LesKaribous/Karibous-2024-PAMI/ECAD/Librairies/ff5a3e2b9e6f647bb54e8a6d02c0a6f1.jpg

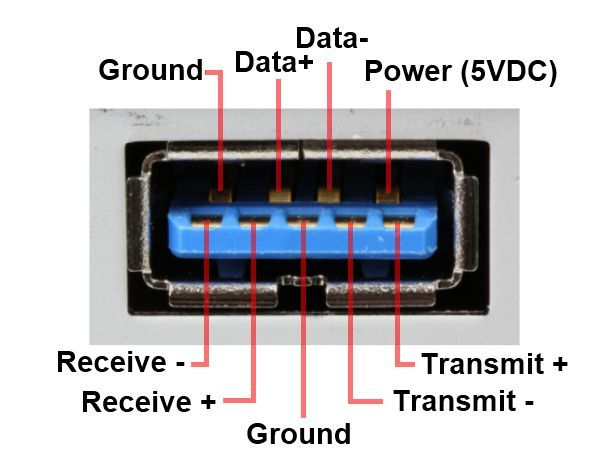
ECAD/Librairies/ff5a3e2b9e6f647bb54e8a6d02c0a6f1.jpg
