LesKaribous/Karibous-2024-PAMI/ECAD/Librairies/ConnectorUSB3.jpg

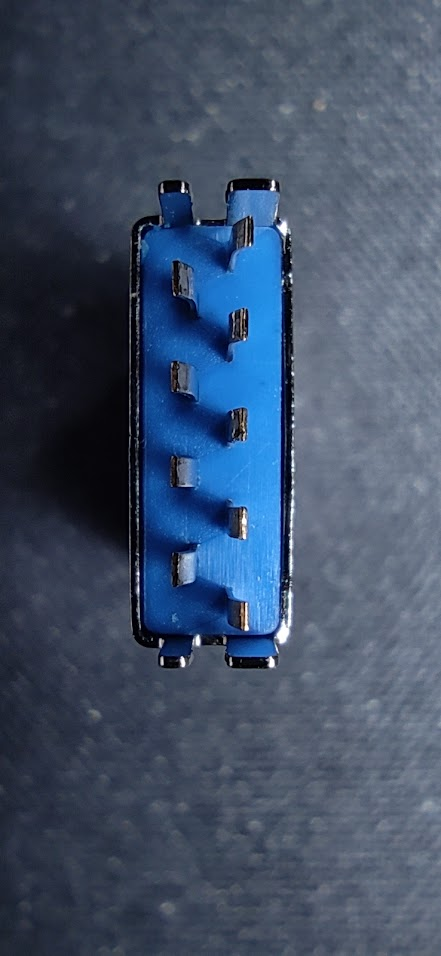
ECAD/Librairies/ConnectorUSB3.jpg
