LesKaribous/Karibous-2024-PAMI/README.md

# Karibous-2024-PAMI
Hardware pour les Petits Automates Mobiles Indépendants de la Coupe de France de Robotique 2024
