LesKaribous/Karibous-2024-PAMI/ECAD/Librairies/H6ca099008dd04cd7b9c7c0162c8ac43c6.png

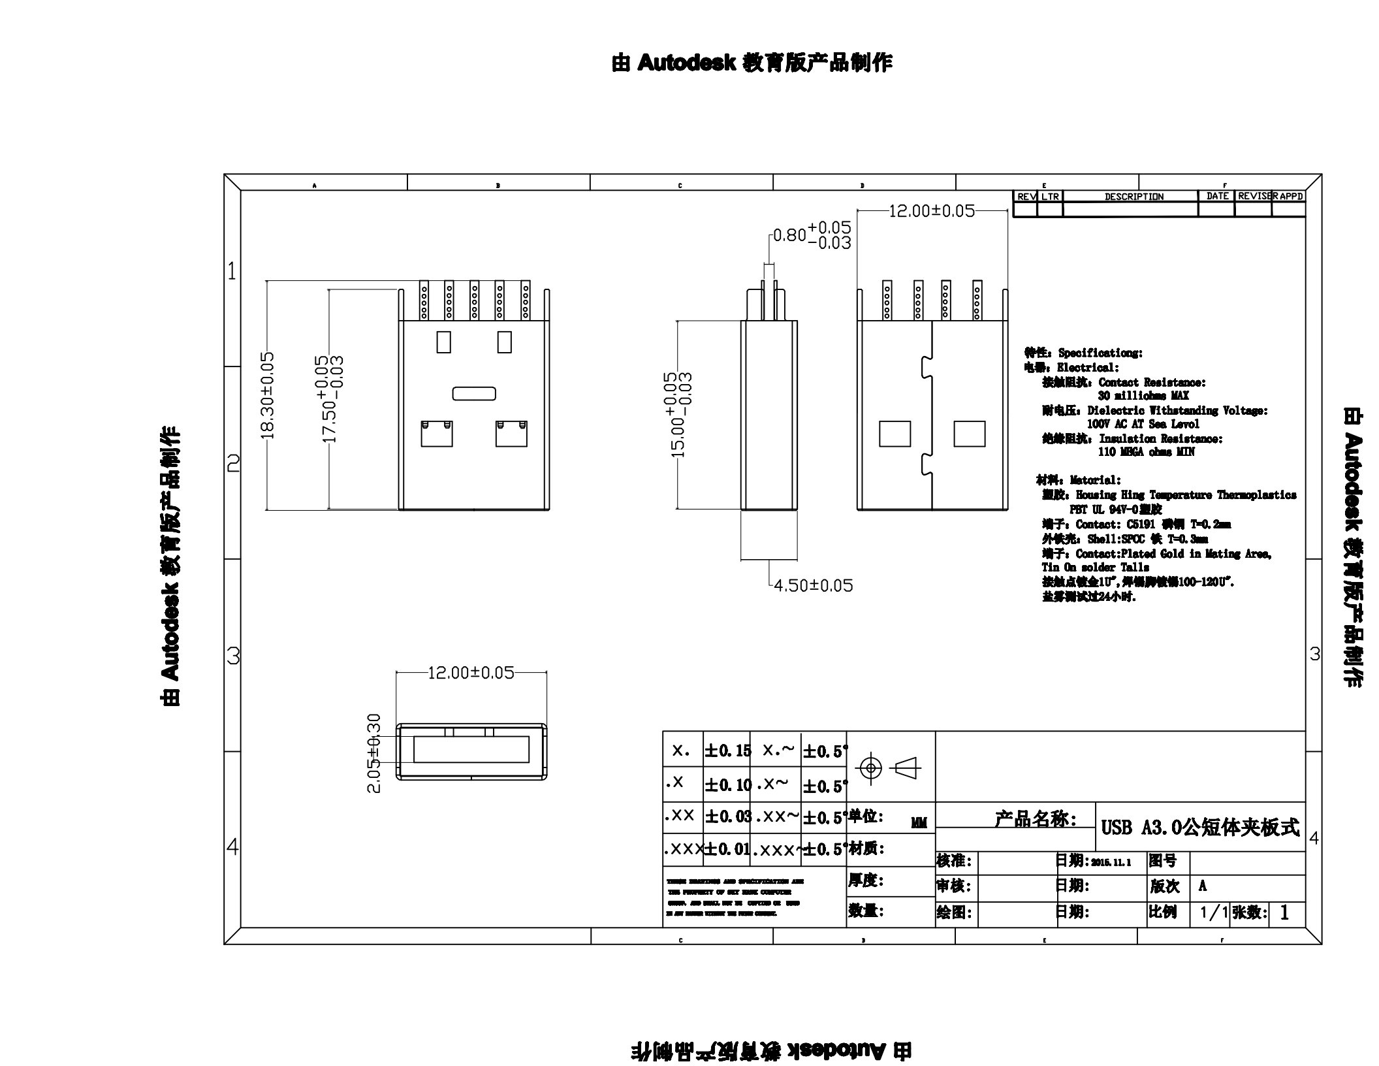
ECAD/Librairies/H6ca099008dd04cd7b9c7c0162c8ac43c6.png
