LesKaribous/Karibous-2024-PAMI/ECAD/Librairies/H062c9b681e61475f8c1c907234bb61a5Y.png_960x960.webp

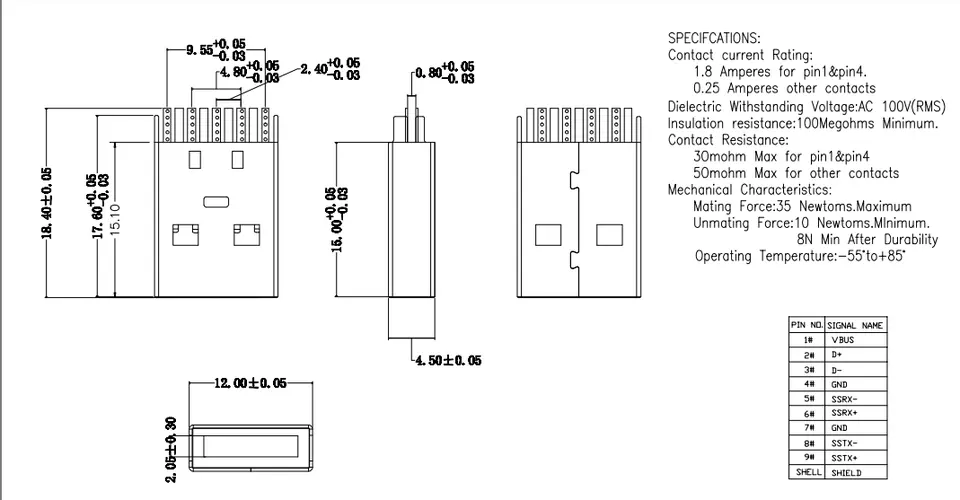
ECAD/Librairies/H062c9b681e61475f8c1c907234bb61a5Y.png_960x960.webp
