LesKaribous/Karibous-2024-PAMI/ECAD/MainBoard-PAMI-2024/Ladybug.png

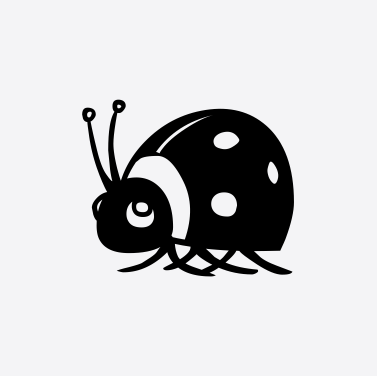
ECAD/MainBoard-PAMI-2024/Ladybug.png
