LesKaribous/Karibous-2024-PAMI/ECAD/MainBoard-PAMI-2024/Pencil.png

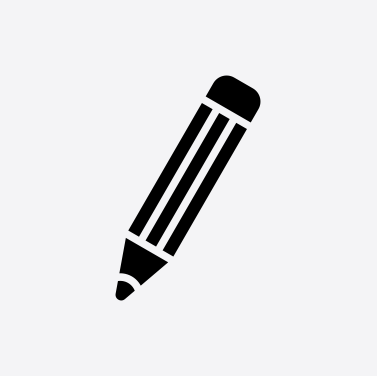
ECAD/MainBoard-PAMI-2024/Pencil.png
