LesKaribous/Karibous-2024-PAMI/ECAD/BatteryAdaptator-2024/BatteryAdaptator-2024.step

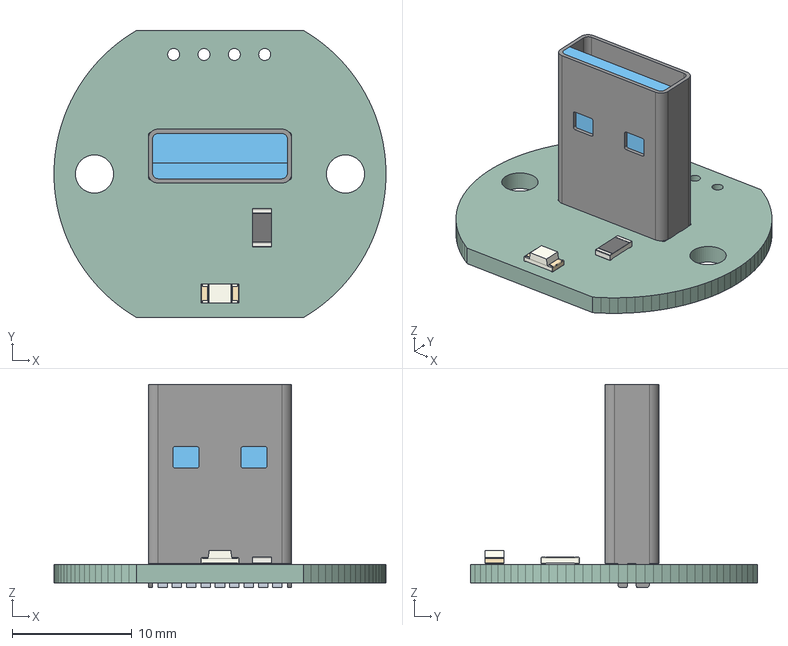
[picture p7: CAD file, 2023-10-08]
ECAD/BatteryAdaptator-2024/BatteryAdaptator-2024.step
27.8 x 24.0 x 17.0 mm
BatteryAdaptator-2024 PCB
