LesKaribous/Karibous-2024-PAMI/ECAD/Librairies/Dissipateur.FCStd

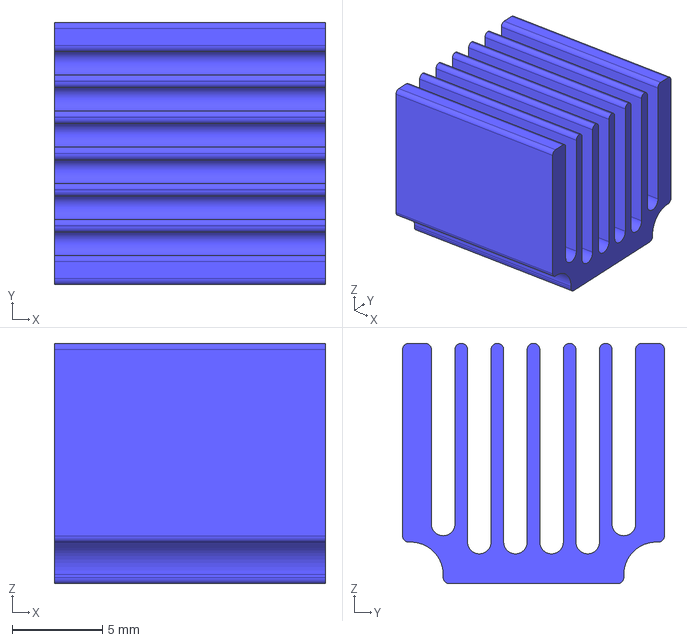
[picture p8: CAD file, 2023-10-30]
ECAD/Librairies/Dissipateur.FCStd
15.0 x 14.5 x 13.3 mm
