LesKaribous/Karibous-2024-PAMI/ECAD/Librairies/TMC2208_SILENTSTEPSTICK/TMC2208_SILENTSTEPSTICK.step

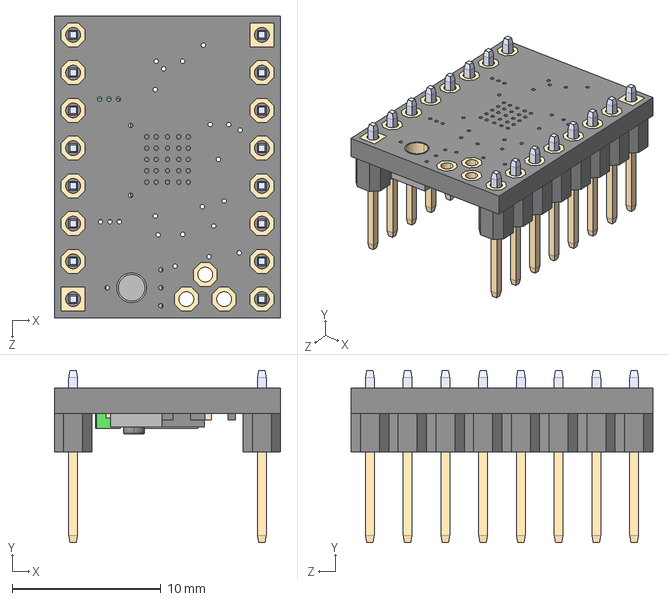
[picture p9: CAD file, 2023-10-21]
ECAD/Librairies/TMC2208_SILENTSTEPSTICK/TMC2208_SILENTSTEPSTICK.step
15.2 x 11.6 x 20.3 mm
