LesKaribous/Karibous-2024-PAMI/MCAD/pami-parts/servo-horn.FCStd

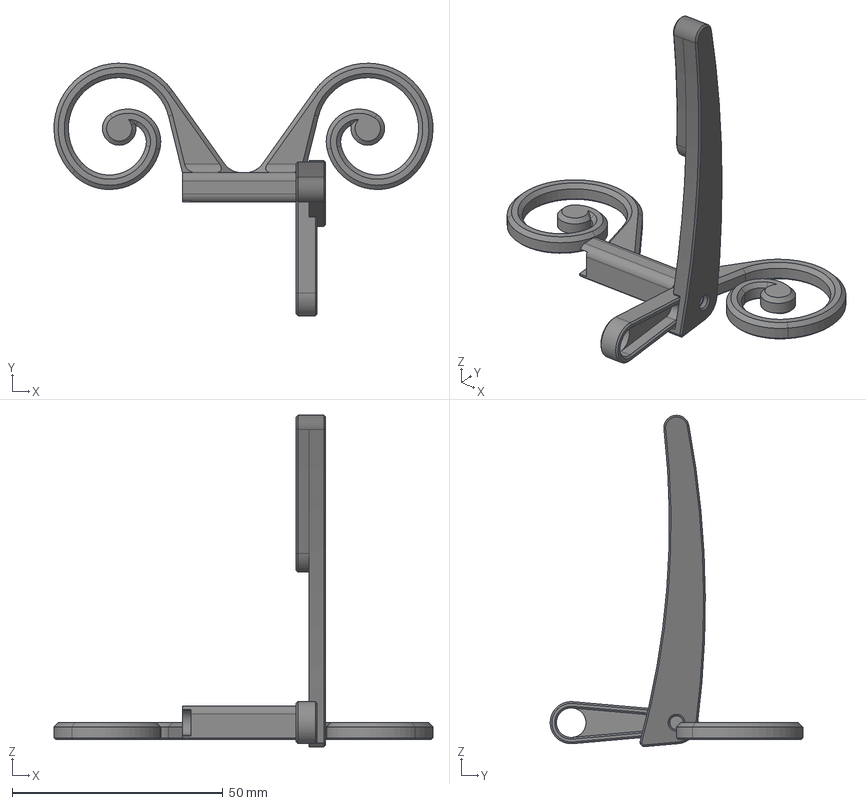
[picture p10: CAD file, 2025-05-25]
MCAD/pami-parts/servo-horn.FCStd
90.0 x 60.0 x 78.7 mm
Horn
Antennas
BrasCrayon
