LesKaribous/Karibous-2024-PAMI/ECAD/Librairies/PinSocket_1x08_P2.54mm_Vertical.step

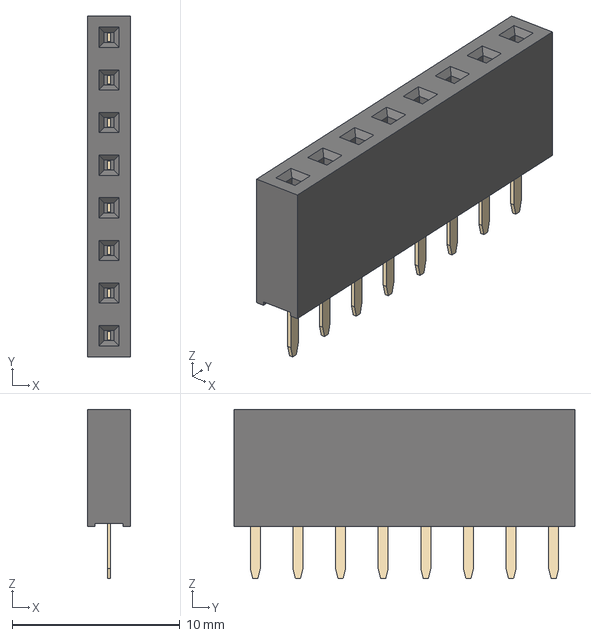
[picture p11: CAD file, 2023-10-30]
ECAD/Librairies/PinSocket_1x08_P2.54mm_Vertical.step
2.54 x 20.3 x 10.1 mm
