LesKaribous/Karibous-2024-PAMI/MCAD/CaleBordure.FCStd

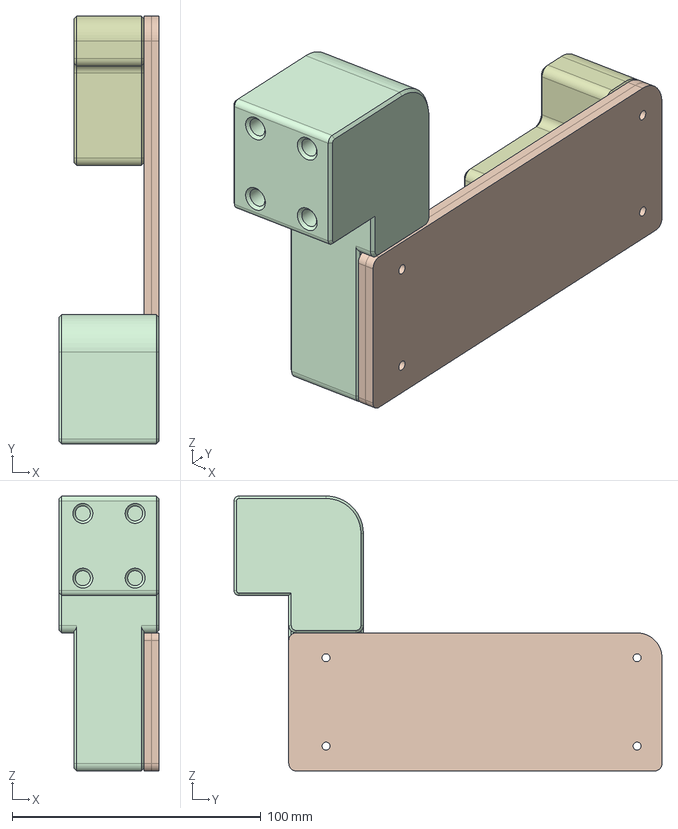
[picture p12: CAD file, 2024-04-07]
MCAD/CaleBordure.FCStd
40.0 x 172.0 x 110.5 mm
V2-BaseClamp
PlateDatum x 2
TIPDatumTool
