LesKaribous/Karibous-2024-PAMI/MCAD/pami-parts/tirette-pami-magnet.FCStd

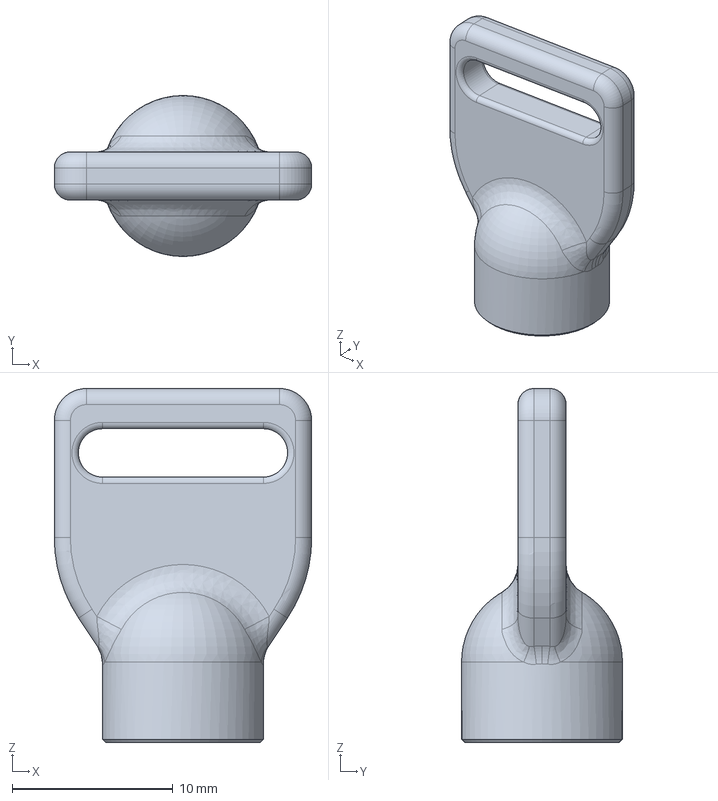
[picture p13: CAD file, 2024-05-01]
MCAD/pami-parts/tirette-pami-magnet.FCStd
16.0 x 10.00 x 22.0 mm
