LesKaribous/Karibous-2024-PAMI/ECAD/Librairies/USB_A_3_Vertical.FCStd

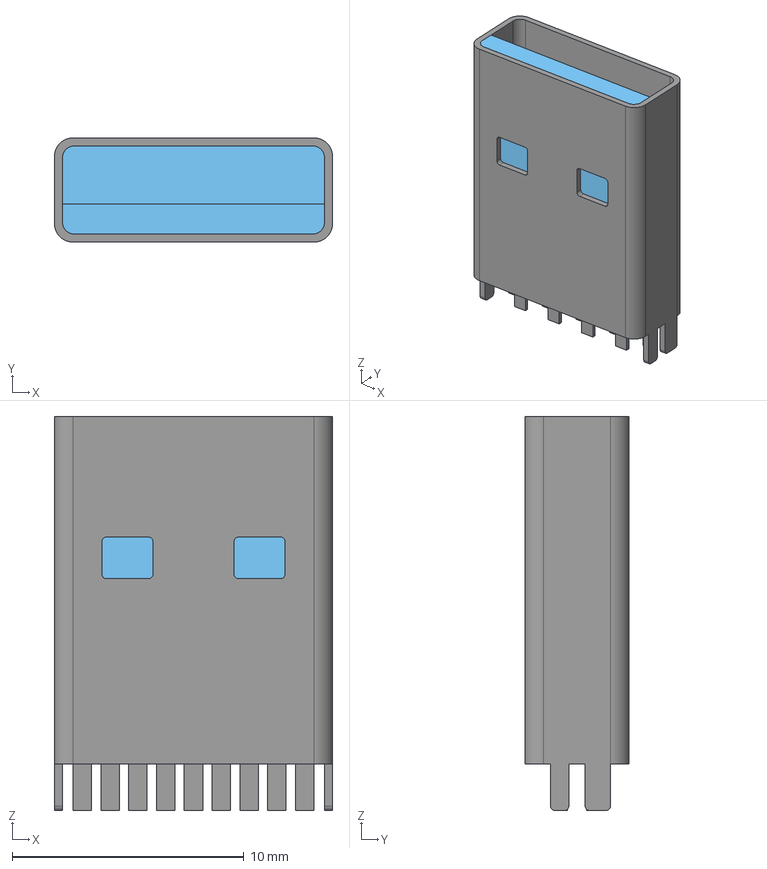
[picture p14: CAD file, 2023-10-08]
ECAD/Librairies/USB_A_3_Vertical.FCStd
12.0 x 4.50 x 17.0 mm
Shield
BlueSupport
Pins
