LesKaribous/Karibous-2024-PAMI/MCAD/DummyPAMI.FCStd

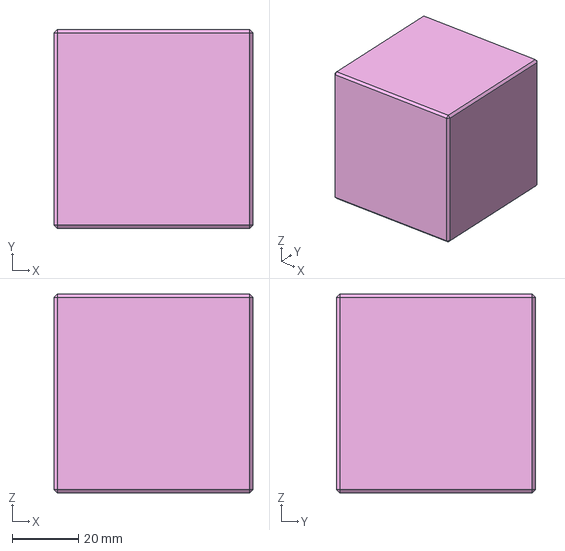
[picture p15: CAD file, 2023-12-13]
MCAD/DummyPAMI.FCStd
60.0 x 60.0 x 60.0 mm
