LesKaribous/Karibous-2024-PAMI/MCAD/pami-parts/motorisation-pami.FCStd

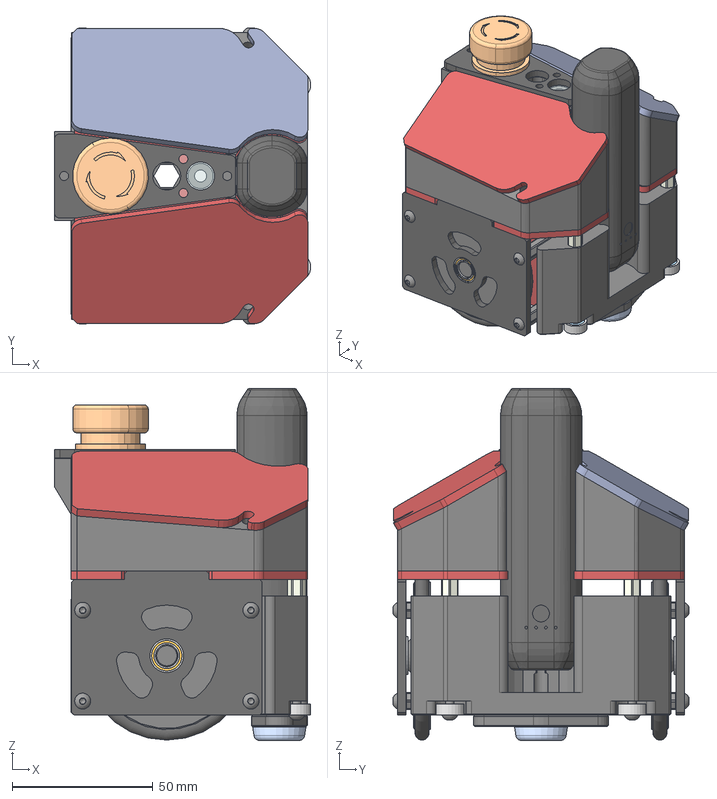
[picture p16: CAD file, 2023-09-24]
MCAD/pami-parts/motorisation-pami.FCStd
91.2 x 105.3 x 125.2 mm
ReedSensorShort
17HS08-1004S x 2
Roue60mm x 2
JointTorique x 2
M3-Insert004 x 4
M3-Insert005 x 4
M3x3-Screw x 4
M3x3-Screw001 x 4
CoreMF128 x 2
SleeveMF128 x 2
MotorPlate x 2
M3x20xx6-Standoff x 4
M3x20xx6-Standoff001 x 4
M3x20xx6-Standoff002 x 4
M3x20xx6-Standoff003 x 4
M3-Insert x 4
M3-Insert001 x 4
M3-Insert002 x 4
M3-Insert003 x 4
M3x6-Screw x 4
M3x6-Screw032 x 4
M3x6-Screw033 x 4
M3x6-Screw034 x 4
M3x6-Screw007 x 4
M3x6-Screw008 x 4
M3x6-Screw009 x 4
M3x6-Screw010 x 4
WheelPlate x 2
MainBody
M3-Insert401 x 2
M3-Insert402 x 2
M3x12-Screw x 2
M3x12-Screw001 x 2
SupportPatin
Patin
M3x8-Screw
M3x8-Screw001
M3-Insert046
M3-Insert047
M3-Insert403 x 2
M3-Insert404 x 2
M3-Insert405 x 2
M3-Insert406 x 2
M3-Insert407 x 2
M3x6xx6-Standoff x 2
M3x6xx6-Standoff071 x 2
M3x6xx6-Standoff072 x 2
TopPlate
PowerBank-B0BHZ6RY6C
BAU
CarterSuperieur
AileGauche
AileDroite
TopCarter
BrideReed
TransferCarter
M4-Washer
