LesKaribous/Karibous-2024-PAMI/MCAD/pami-parts/Roulements623ZZ.step

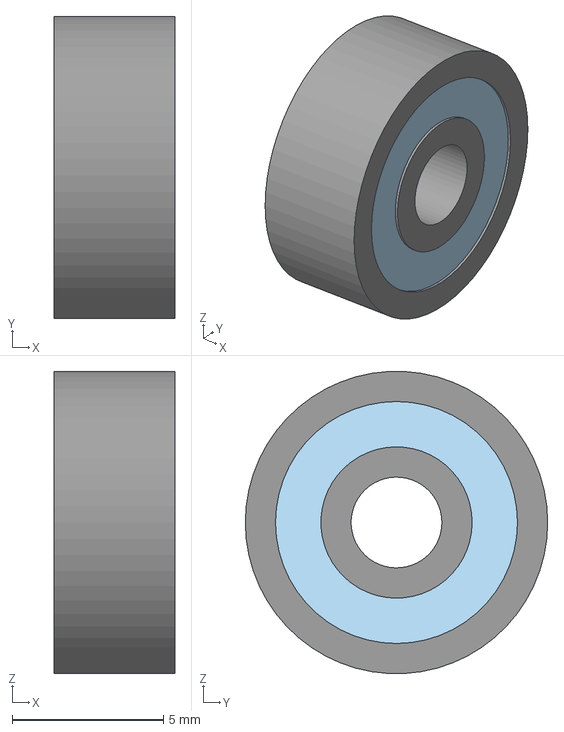
[picture p17: CAD file, 2023-09-23]
MCAD/pami-parts/Roulements623ZZ.step
4.00 x 10.0 x 9.99 mm
