LesKaribous/Karibous-2024-PAMI/MCAD/pami-parts/RoulementsMF128.step

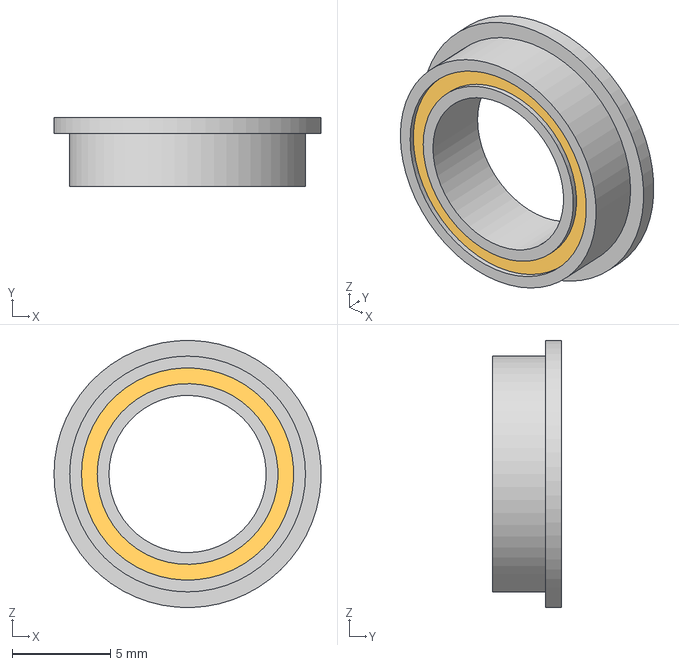
[picture p18: CAD file, 2023-09-23]
MCAD/pami-parts/RoulementsMF128.step
13.6 x 3.50 x 13.6 mm
CoreMF128
SleeveMF128
