LesKaribous/Karibous-2024-PAMI/MCAD/pami-parts/RCWL-1601.step

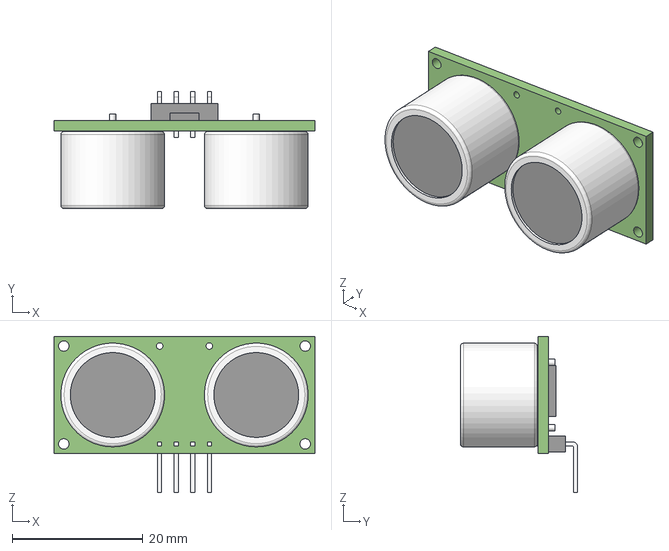
[picture p19: CAD file, 2023-09-23]
MCAD/pami-parts/RCWL-1601.step
40.0 x 18.0 x 24.0 mm
