LesKaribous/Karibous-2024-PAMI/(list of files, cad)

Other CAD files:
MCAD/pami_2024.FCStd
MCAD/pami-parts/tirette-pami.FCStd
