LesKaribous/Karibous-2024-PAMI/ECAD/MainBoard-PAMI-2024/MainBoard-PAMI-2024.kicad_pcb

## KiCad design ECAD/MainBoard-PAMI-2024/MainBoard-PAMI-2024.kicad_pcb (2023-11-02)

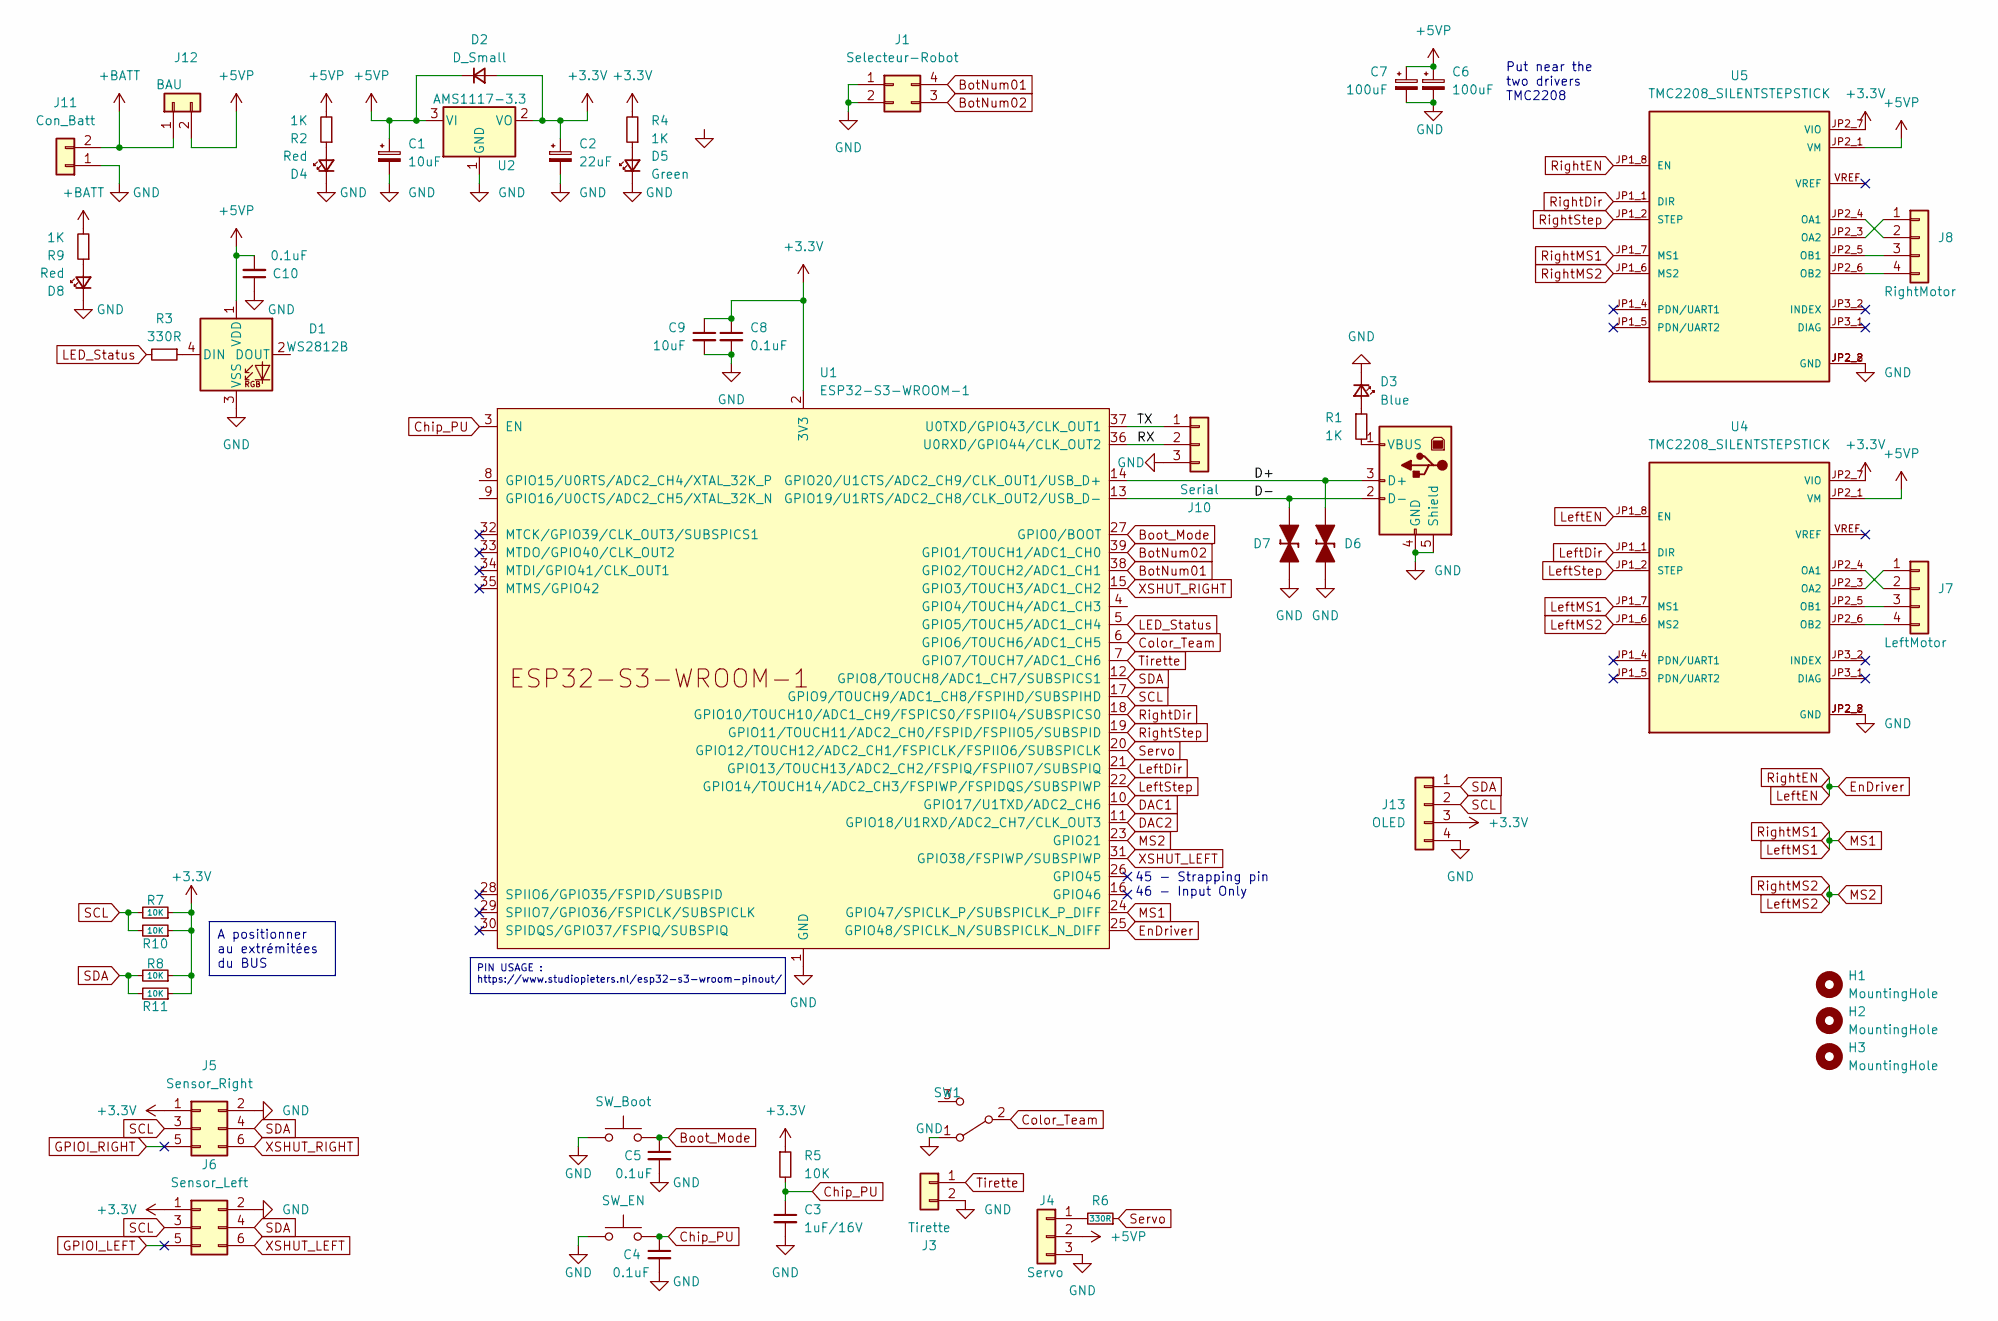
[picture p20: schematic MainBoard-PAMI-2024.kicad_sch]

Parts:
C1: 10uF; CP_Elec_5x5.4
C2: 22uF; CP_EIA-3528-12_Kemet-T_Pad1.50x2.35mm_HandSolder
C3: 1uF/16V; C_1206_3216Metric
C4, C5, C10: 0.1uF; C_1206_3216Metric
C6, C7: 100uF; CP_Radial_D8.0mm_P3.80mm
C8: 0.1uF; C_1206_3216Metric_Pad1.33x1.80mm_HandSolder
C9: 10uF; C_1206_3216Metric_Pad1.33x1.80mm_HandSolder
D1: WS2812B; LED_WS2812B_PLCC4_5.0x5.0mm_P3.2mm
D2: D_Small; D_SMA_Handsoldering
D3: Blue; LED_1206_3216Metric
D4, D8: Red; LED_1206_3216Metric
D5: Green; LED_1206_3216Metric
D6, D7: D_TVS_Bidirectional_Generic; D_SOD-523
H1, H2, H3: MountingHole; MountingHole_3.2mm_M3
J1: Selecteur-Robot; PinHeader_2x02_P2.54mm_Vertical
J2: USB_B; USB_B_Lumberg_2411_02_Horizontal
J3: Tirette; Molex_KK-254_AE-6410-02A_1x02_P2.54mm_Vertical
J4: Servo; PinHeader_1x03_P2.54mm_Vertical
J5: Sensor_Right; IDC-Header_2x03_P2.54mm_Vertical
J6: Sensor_Left; IDC-Header_2x03_P2.54mm_Vertical
J7: LeftMotor; PinHeader_1x04_P2.54mm_Vertical
J8: RightMotor; PinHeader_1x04_P2.54mm_Vertical
J10: Serial; PinHeader_1x03_P2.54mm_Vertical
J11: Con_Batt; AMASS_XT30U-F_1x02_P5.0mm_Vertical
J12: BAU; Molex_KK-396_A-41791-0002_1x02_P3.96mm_Vertical
J13: OLED; Molex_KK-254_AE-6410-04A_1x04_P2.54mm_Vertical
R1, R2, R4, R9: 1K; R_1206_3216Metric_Pad1.30x1.75mm_HandSolder
R3, R6: 330R; R_1206_3216Metric_Pad1.30x1.75mm_HandSolder
R5, R7, R8, R10, R11: 10K; R_1206_3216Metric_Pad1.30x1.75mm_HandSolder
SW1: SW_SPDT; SK-12D10 1P2T
SWBoot1: SW_Boot; SW_SPST_CK_RS282G05A3
SWEn1: SW_EN; SW_SPST_CK_RS282G05A3
U1: ESP32-S3-WROOM-1
U2: AMS1117-3.3; SOT-223-3_TabPin2
U4, U5: TMC2208_SILENTSTEPSTICK; MODULE_TMC2208_SILENTSTEPSTICK

Connections:
+3.3V: C2.1, C8.1, C9.1, D2.2 (A), J5.1, J6.1, J13.3, R4.2, R5.1, R7.1, R8.1, R10.1, R11.1, U1.2 (3V3), U2.2 (VO), U4.JP2_7 (VIO), U5.JP2_7 (VIO)
+5VP: C1.1, C6.1, C7.1, C10.2, D1.1 (VDD), D2.1 (K), J4.2, J12.2, R2.2, U2.3 (VI), U4.JP2_1 (VM), U5.JP2_1 (VM)
+BATT: J11.2, J12.1, R9.2
/D+: D6.2 (A), J2.3 (D+), U1.14 (GPIO20/U1CTS/ADC2_CH9/CLK_OUT1/USB_D+)
/D-: D7.2 (A), J2.2 (D-), U1.13 (GPIO19/U1RTS/ADC2_CH8/CLK_OUT2/USB_D-)
/RX: J10.2, U1.36 (U0RXD/GPIO44/CLK_OUT2)
/TX: J10.1, U1.37 (U0TXD/GPIO43/CLK_OUT1)
Boot_Mode: C5.1, SWBoot1.2, U1.27 (GPIO0/BOOT)
BotNum01: J1.4, U1.38 (GPIO2/TOUCH2/ADC1_CH1)
BotNum02: J1.3, U1.39 (GPIO1/TOUCH1/ADC1_CH0)
Chip_PU: C3.1, C4.1, R5.2, SWEn1.2, U1.3 (EN)
Color_Team: SW1.2 (B), U1.6 (GPIO6/TOUCH6/ADC1_CH5)
DAC1: U1.10 (GPIO17/U1TXD/ADC2_CH6)
DAC2: U1.11 (GPIO18/U1RXD/ADC2_CH7/CLK_OUT3)
EnDriver: U1.25 (GPIO48/SPICLK_N/SUBSPICLK_N_DIFF), U4.JP1_8 (EN), U5.JP1_8 (EN)
GND: C1.2, C2.2, C3.2, C4.2, C5.2, C6.2, C7.2, C8.2, C9.2, C10.1, D1.3 (VSS), D3.1 (K), D4.1 (K), D5.1 (K), D6.1 (K), D7.1 (K), D8.1 (K), J1.1, J1.2, J2.4 (GND), J2.5 (Shield), J3.2, J4.3, J5.2, J6.2, J10.3, J11.1, J13.4, SW1.1 (A), SWBoot1.1, SWEn1.1, U1.1 (GND), U1.40 (GND), U1.41 (GND), U2.1 (GND), U4.JP2_2 (GND), U4.JP2_8 (GND), U5.JP2_2 (GND), U5.JP2_8 (GND)
GPIOI_LEFT: J6.5
GPIOI_RIGHT: J5.5
LED_Status: R3.2, U1.5 (GPIO5/TOUCH5/ADC1_CH4)
LeftDir: U1.21 (GPIO13/TOUCH13/ADC2_CH2/FSPIQ/FSPIIO7/S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), U4.JP1_1 (DIR)
LeftMS1: U1.24 (GPIO47/SPICLK_P/SUBSPICLK_P_DIFF), U4.JP1_7 (MS1), U5.JP1_7 (MS1)
LeftMS2: U1.23 (GPIO21), U4.JP1_6 (MS2), U5.JP1_6 (MS2)
LeftStep: U1.22 (GPIO14/TOUCH14/ADC2_CH3/FSPIWP/FSPIDQS/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), U4.JP1_2 (STEP)
unnamed: D1.4 (DIN), R3.1
unnamed: D3.2 (A), R1.1
unnamed: D4.2 (A), R2.1
unnamed: D5.2 (A), R4.1
unnamed: D8.2 (A), R9.1
unnamed: J2.1 (VBUS), R1.2
unnamed: J4.1, R6.2
unnamed: J7.1, U4.JP2_3 (OA2)
unnamed: J7.2, U4.JP2_4 (OA1)
unnamed: J7.3, U4.JP2_5 (OB1)
unnamed: J7.4, U4.JP2_6 (OB2)
unnamed: J8.1, U5.JP2_3 (OA2)
unnamed: J8.2, U5.JP2_4 (OA1)
unnamed: J8.3, U5.JP2_5 (OB1)
unnamed: J8.4, U5.JP2_6 (OB2)
RightDir: U1.18 (GPIO10/TOUCH10/ADC1_CH9/FSPICS0/FSPIIO4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), U5.JP1_1 (DIR)
RightStep: U1.19 (GPIO11/TOUCH11/ADC2_CH0/FSPID/FSPIIO5/S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), U5.JP1_2 (STEP)
SCL: J5.3, J6.3, J13.2, R7.2, R10.2, U1.17 (GPIO9/TOUCH9/ADC1_CH8/FSPIHD/SUBSPIHD)
SDA: J5.4, J6.4, J13.1, R8.2, R11.2, U1.12 (GPIO8/TOUCH8/ADC1_CH7/SUBSPICS1)
Servo: R6.1, U1.20 (GPIO12/TOUCH12/ADC2_CH1/FSPICLK/FSPIIO6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)
Tirette: J3.1, U1.7 (GPIO7/TOUCH7/ADC1_CH6)
XSHUT_LEFT: J6.6, U1.31 (GPIO38/FSPIWP/SUBSPIWP)
XSHUT_RIGHT: J5.6, U1.15 (GPIO3/TOUCH3/ADC1_CH2)

Notes on the sheet:
PIN USAGE : https://www.studiopieters.nl/esp32-s3-wroom-pinout/
A positionner au extrémitées du BUS
Put near the two drivers TMC2208
45 - Strapping pin 46 - Input Only

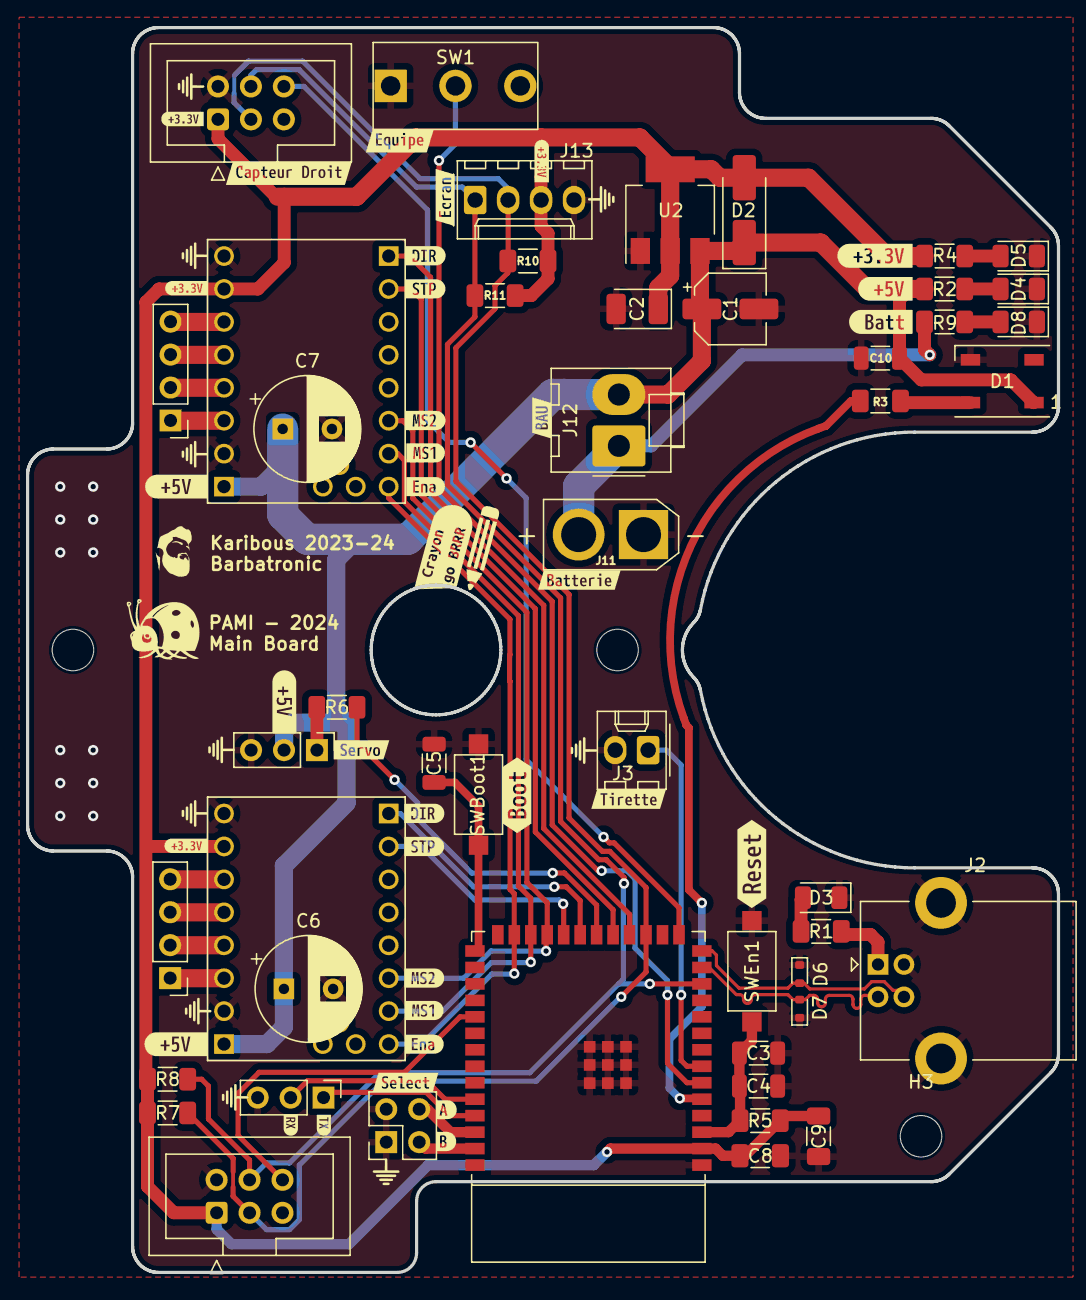
[picture p21: board MainBoard-PAMI-2024.kicad_pcb from above]

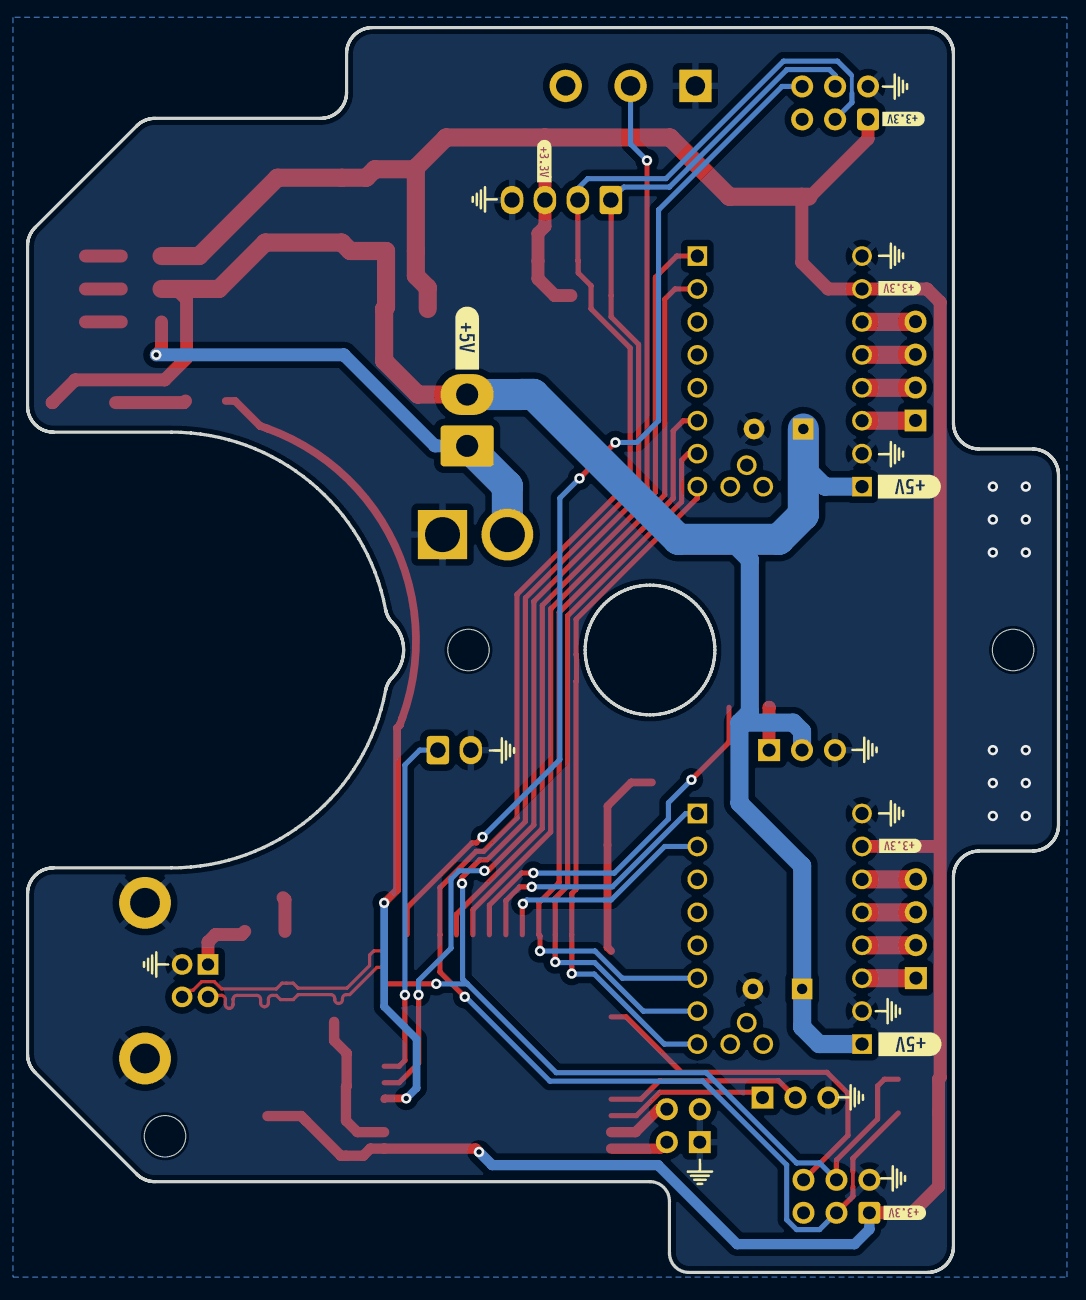
[picture p22: board MainBoard-PAMI-2024.kicad_pcb from below]

Board: 2 copper layers, 79.5 x 96.0 mm, 94 parts (8 on the bottom side), 42 nets.

Other parts of the board:
kibuzzard-65422A0E: G***; kibuzzard-65422A0E
kibuzzard-65422A22: G***; kibuzzard-65422A22
kibuzzard-65422AAE: G***; kibuzzard-65422AAE
kibuzzard-65422AB6: G***; kibuzzard-65422AB6
kibuzzard-65422AC7: G***; kibuzzard-65422AC7
kibuzzard-65422F57: G***; kibuzzard-65422F57
kibuzzard-654226B4, kibuzzard-654226B4#2, kibuzzard-654226B4#3, kibuzzard-654226B4#4, kibuzzard-654226B4#5, kibuzzard-654226B4#6, kibuzzard-654226B4#7, kibuzzard-654226B4#8, kibuzzard-654226B4#9: G***; kibuzzard-654226B4
kibuzzard-654229BB: G***; kibuzzard-654229BB
kibuzzard-654230EB: G***; kibuzzard-654230EB
kibuzzard-654231C8, kibuzzard-654231C8#2: G***; kibuzzard-654231C8
kibuzzard-654231D0, kibuzzard-654231D0#2: G***; kibuzzard-654231D0
kibuzzard-654231D6, kibuzzard-654231D6#2: G***; kibuzzard-654231D6
kibuzzard-654231DD, kibuzzard-654231DD#2: G***; kibuzzard-654231DD
kibuzzard-6542284D: G***; kibuzzard-6542284D
kibuzzard-6542299D: G***; kibuzzard-6542299D
kibuzzard-6542315C: G***; kibuzzard-6542315C
kibuzzard-65231966, kibuzzard-65231966#2, kibuzzard-65231966#3, kibuzzard-65231966#4, kibuzzard-65231966#5, kibuzzard-65231966#6: G***; kibuzzard-65231966
kibuzzard-65422827: G***; kibuzzard-65422827
kibuzzard-65422864: G***; kibuzzard-65422864
kibuzzard-65422975: G***; kibuzzard-65422975
kibuzzard-65422987: G***; kibuzzard-65422987
kibuzzard-65423033: G***; kibuzzard-65423033
kibuzzard-65423064: G***; kibuzzard-65423064
kibuzzard-65423077: G***; kibuzzard-65423077
kibuzzard-65423198, kibuzzard-65423198#2: G***; kibuzzard-65423198
