LesKaribous/Karibous-2024-PAMI/ECAD/BatteryAdaptator-2024/BatteryAdaptator-2024.kicad_pcb

## KiCad design ECAD/BatteryAdaptator-2024/BatteryAdaptator-2024.kicad_pcb (2023-10-08)

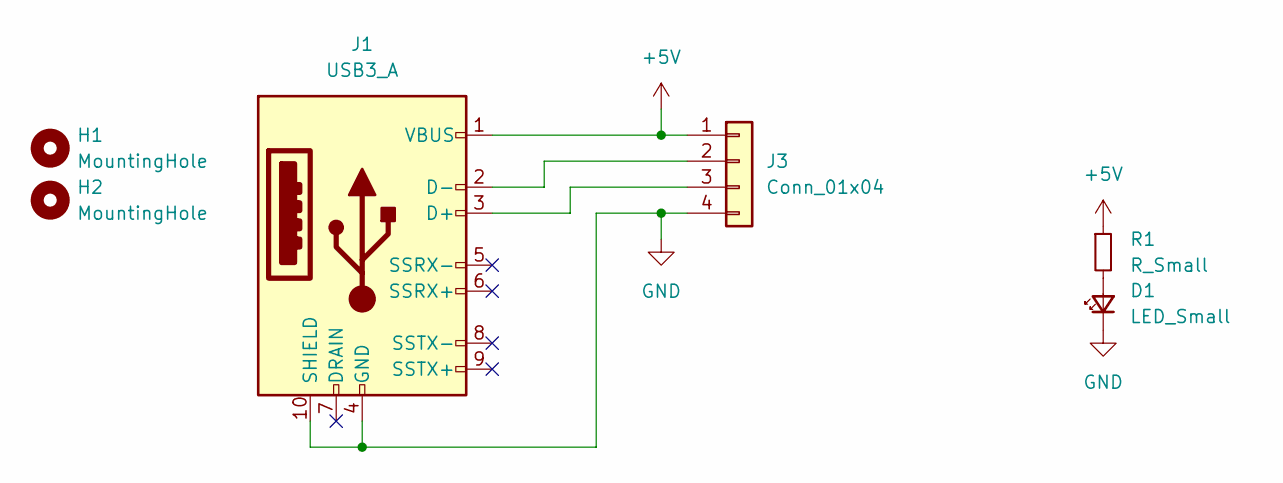
[picture p23: schematic BatteryAdaptator-2024.kicad_sch]

Parts:
D1: LED_Small; LED_1206_3216Metric
H1, H2: MountingHole; MountingHole_3.2mm_M3
J1: USB3_A; USB A3.0 - PowerBank XHC-005
J3: Conn_01x04; PinHeader_1x04_P2.54mm_Vertical
R1: R_Small; R_1206_3216Metric

Connections:
+5V: J1.1 (VBUS), J3.1, R1.1
GND: D1.1 (K), J1.4 (GND), J1.10 (SHIELD), J3.4
unnamed: D1.2 (A), R1.2
unnamed: J1.3 (D+), J3.3
unnamed: J1.2 (D-), J3.2

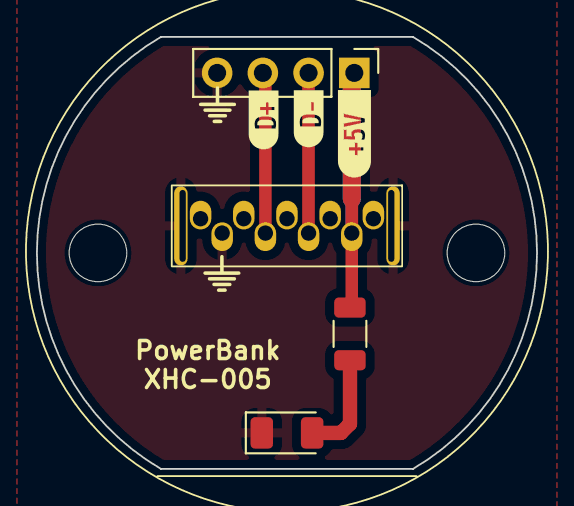
[picture p24: board BatteryAdaptator-2024.kicad_pcb from above]

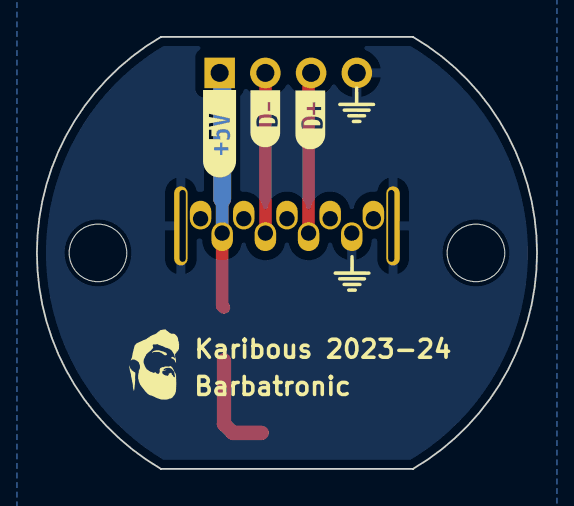
[picture p25: board BatteryAdaptator-2024.kicad_pcb from below]

Board: 2 copper layers, 27.8 x 24.0 mm, 12 parts (3 on the bottom side), 5 nets.

Other parts of the board:
kibuzzard-652319A9, kibuzzard-652319A9#2: G***; kibuzzard-652319A9
kibuzzard-652319B5, kibuzzard-652319B5#2: G***; kibuzzard-652319B5
kibuzzard-65231966, kibuzzard-65231966#2: G***; kibuzzard-65231966
