LesKaribous/Karibous-2024-PAMI/FIRMWARE/Firmware-PAMI-2024/src/main.cpp

#include <Arduino.h>
#include "pins.h"
#include "ihm.h"
#include "sensors.h"
#include "actuators.h"
#include "motion.h"
#include "match.h"

void waitStart();
void datumPosition(int robotNumber, int teamColor);
void match();
void strategiePAMI();
void drawing();

void setup() {

  initIHM();
  initSensor();
  initMotion();
  initActuators();

  drawSplashScreen();
  //pairingScreen();
  drawBackLcd();

  enableMotors();
  antennasDown();
  delay(1000);
  antennasUp();

  waitStart();
}

void loop() 
{
  updateMatchTime();
  match();
}

void waitStart(){
  // Attendre que la tirette n'est soit plus présente
  infoLCD("Remove Tirette");
  while(getTirette()) {
    delay(500); 
    checkColorTeam();
  }
  // Attendre que la tirette soit insérée
  infoLCD("Insert Tirette");
  while(!getTirette()) {
    delay(500); 
    checkColorTeam();
  }
  // Datum position du PAMI
  delay(2000);
  datumPosition(getRobotNumber(), getTeamColor());
  setRobotState(READY);
  infoLCD("Robot Ready");
  delay(2000);
  // Attendre que la tirette soit bien insérée pour éviter les faux-départs
  infoLCD("Insert Tirette");
  while(!getTirette()) delay(500);
  // Attendre que la tirette soit retirée pour débuter le match
  infoLCD("Wait Start");
  while(getTirette()) delay(250);
  // Le match commence
  setRobotState(MATCH_STARTED);
  infoLCD("Go Match !");
  // Démarrage du compteur !
  startMatch();
}

void datumPosition(int robotNumber, int teamColor){

  // Datum at low Speed
  setMaxSpeed(DATUM_SPEED);
  setAcceleration(DATUM_ACCELERATION);
  // Datum Y
  go(-100);
  // Save Y position and orientation
  setCurrentY(CENTER_POSITION_MM);
  setCurrentRot(270);

  if (teamColor == TEAM_BLUE){
    
    // Orientate robot
    goTo(0,80,0);
    go(-100);
    // SaveX position and orientation
    setCurrentX(1050+CENTER_POSITION_MM);
    setCurrentRot(0);

    if(robotNumber == 1) goTo(1120,80,270); // Go to safe position
    else if(robotNumber == 2) goTo(1120+130,80,270); // Go to safe position
    else if(robotNumber == 3) goTo(1120+260,80,270); // Go to safe position
    else debug("ERROR robot number");
  }
  else if (teamColor == TEAM_YELLOW){
    goTo(0,80,180);
    go(-100);
    // SaveX position and orientation
    setCurrentX(1950-CENTER_POSITION_MM);
    setCurrentRot(180);

    if(robotNumber == 1) goTo(1880,80,270); // Go to safe position
    else if(robotNumber == 2) goTo(1880-130,80,270); // Go to safe position
    else if(robotNumber == 3) goTo(1880-260,80,270); // Go to safe position
    else debug("ERROR robot number");
  }

  setMaxSpeed(MAX_SPEED);
  setAcceleration(MAX_ACCELERATION);
}

void match(){
  if(getMatchState() == PAMI_RUN){
    enableMotors();
    strategiePAMI();
    setMatchState(PAMI_STOP);
  }
  else if (getMatchState() == PAMI_STOP){
    disableMotors(); // Desactive les moteurs
    while(1); // Fin de match
  }
  else {
    disableMotors(); // Desactive les moteurs
  }  
}

void strategiePAMI(){

  setOpponentChecking(true);
  if(getRobotNumber() == 1){
    if(getTeamColor() == TEAM_BLUE){
      goTo(750,180);
      setOpponentChecking(false);
      goTo(750,0);
      antennasDown();
    }
    else{
      goTo(3000-750,180);
      setOpponentChecking(false);
      goTo(3000-750,0);
      antennasDown();
    }
  }
  else if(getRobotNumber() == 2){
    if(getTeamColor() == TEAM_BLUE){
      goTo(1200,300);
      goTo(600,300);
      setOpponentChecking(false);
      goTo(400,300);
      antennasDown();
    }
    else{
      goTo(3000-1200,300);
      goTo(3000-600,300);
      setOpponentChecking(false);
      goTo(3000-400,300);
      antennasDown();
    }
  }
  else if(getRobotNumber() == 3){
    if(getTeamColor() == TEAM_BLUE){
      goTo(1350,450);
      goTo(400,550);
      setOpponentChecking(false);
      goTo(0,550);
      antennasDown();
    }
    else{
      goTo(3000-1350,450);
      goTo(3000-400,550);
      setOpponentChecking(false);
      goTo(3000-0,550);
      antennasDown();
    }
  }
}
