LesKaribous/Karibous-2024-PAMI/FIRMWARE/Firmware-PAMI-2024/src/pins.h

// pins.h
#ifndef PINS_H
#define PINS_H

// Pins Robot Number
const int BotNumb01 = 2;
const int BotNumb02 = 1;

// Pins Motors - Drivers
const int EN      = 48;
const int STEP_G  = 11;
const int DIR_G   = 10;
const int STEP_D  = 14;
const int DIR_D   = 13;
const int MS1 = 47;
const int MS2 = 21;

// Pins IHM
const int ColorTeam = 6;
const int Tirette   = 7;
const int ledStatus = 5;

// Pins servo
const int pinServo  = 12;

// Pins Sensors
const int xshutPins[2] = { 3,38 };

#endif // PINS_H
