LesKaribous/Karibous-2024-PAMI/FIRMWARE/Firmware-PAMI-2024/src/motion.h

// motion.h
#ifndef MOTION_H
#define MOTION_H

#include <Arduino.h>
#include <AccelStepper.h>

#include "pins.h" 
#include "ihm.h" 
#include "sensors.h"
#include "match.h"

#define STEPS_PER_REVOLUTION 200    // Nombre de pas par tour du moteur
#define WHEEL_DIAMETER_MM 60.0f     // Diamètre de la roue en millimètres
#define WHEEL_DISTANCE_MM 85.0f     // Distance entre les roues en millimètres

#define MAX_SPEED       10000.0
#define MAX_ACCELERATION    2000.0

#define DATUM_SPEED    5000.0
#define DATUM_ACCELERATION 500.0

#define STOP_SPEED      20000.0
#define STOP_ACCELERATION   4000.0

#define CENTER_POSITION_MM 50       // Valeur entre l'arriere du robot et le centre des roues en millimètres

#define MOTION_WAIT 0
#define MOTION_RUN 1
#define MOTION_STOP 2

// Structure pour représenter une position et une orientation absolue du robot
struct Pose {
    float x; // Position en X (mm)
    float y; // Position en Y (mm)
    float rot; // Rotation en degrés

    // Méthodes pour définir les valeurs
    void setX(float _x) { x = _x; }
    void setY(float _y) { y = _y; }
    void setRot(float _rot) { rot = _rot; }

    // Méthodes pour obtenir les valeurs
    float getX() const { return x; }
    float getY() const { return y; }
    float getRot() const { return rot; }
}; 

// Structure pour représenter undéplacement polaire relatif du robot
struct PolarMove {
    float rotation1; // Première rotation pour s'aligner vers la cible
    float distance;  // Déplacement linéaire vers la cible
    float rotation2; // Rotation finale pour ajuster l'orientation
};

enum StepMode {
    EIGHTH_STEP,      // MS1 = GND, MS2 = GND
    HALF_STEP,        // MS1 = GND, MS2 = VIO
    QUARTER_STEP,     // MS1 = VIO, MS2 = GND
    SIXTEENTH_STEP    // MS1 = VIO, MS2 = VIO
};

// Déclaration des objets comme externes
extern AccelStepper motor_D;
extern AccelStepper motor_G;

// Déclaration des fonctions

void initMotion();
void setStepMode(StepMode mode); 
void enableMotors();
void disableMotors();
void setMaxSpeed(float _maxSpeed = MAX_SPEED);
void setAcceleration(float _acceleration = MAX_ACCELERATION);
void updateMotors();

void setCurrentY(float _y);
void setCurrentX(float _x);
void setCurrentRot(float _rot);

void processMove();
void setOpponentChecking(bool _opponentChecking);
void setMotionState(int _motionState);

long convertDistToStep(float _dist);
long convertAngleToStep(float angle);

// Déplacements relatifs
void go(float _dist);
void turn(float _angle);
void turnGo(float _angle, float _dist);

// Déplacements absolus
void goTo(Pose _target);
void goTo(float _x, float _y);
void goTo(float _x, float _y, float _rot);

// Converti la position demandée vers le targetPolarMove
void convertToPolar(Pose _target);
void convertToPolar(float _x, float _y);
void convertToPolar(float _x, float _y, float _rot);


#endif // MOTION_H
