LesKaribous/Karibous-2024-PAMI/FIRMWARE/Firmware-PAMI-2024/src/actuators.h

// actuators.h
#ifndef ACTUATORS_H
#define ACTUATORS_H

#include <Arduino.h>
#include <Servo.h> // use ServoESP32 lib - Version 1.1.1 - See https://github.com/RoboticsBrno/ServoESP32/issues/26 if compilation issues - On linux , use 1.1.0

#include "pins.h" 
#include "ihm.h"

#define ANTENNA_UP 120
#define ANTENNA_DOWN 100

// Déclaration des fonctions
void initActuators();
void antennasDown();
void antennasUp();
void penDown();
void penUp();
void testAntennas();

#endif // ACTUATORS_H
