LesKaribous/Karibous-2024-PAMI/(commit log)

2023-09-21 create file
    [BatteryAdaptator-2024.kicad_pcb, BatteryAdaptator-2024.kicad_sch, MainBoard-PAMI-2024.kicad_pcb, MainBoard-PAMI-2024.kicad_sch, motorisation-pami.FCStd, pami_2024.FCStd]
2023-09-23 add part
    [RCWL-1601.step, Roulements623ZZ.step, RoulementsMF128.step]
2023-09-23 V2 motorisation & V1 carter
    [motorisation-pami.FCStd]
2023-09-24 laser and tirette (live 175)
    [motorisation-pami.FCStd, pami_2024.FCStd]
2023-09-25 add servo
    [pami_2024.FCStd]
2023-09-27 add hole for the Head
    [pami_2024.FCStd]
2023-09-27 add VL53L0X sensor
    [pami_2024.FCStd]
2023-09-27 first test with PCB cut
    [MainBoard-PAMI-2024.kicad_pcb]
2023-09-29 Modify Cut / Add components
    Add :
    - Connectors
    - new Cut
    - Regulator
    - LEDs
    - USB
    [MainBoard-PAMI-2024.kicad_pcb, MainBoard-PAMI-2024.kicad_sch]
2023-09-29 Modify PCB - Add hole for Servo
    [pami_2024.FCStd]
2023-09-30 add rod on wings
    [pami_2024.FCStd]
2023-10-01 Add parts
    - Add head
    - Add eyes
    - Add BAU extender
    - add screws on the wings
    - fix top position
    [pami_2024.FCStd]
2023-10-01 add buzzer
    [MainBoard-PAMI-2024.kicad_sch]
2023-10-01 add pen hole and opto sensor
    [MainBoard-PAMI-2024.kicad_pcb, MainBoard-PAMI-2024.kicad_sch]
2023-10-01 Hole for the pencil
    [pami_2024.FCStd]
2023-10-08 update live 177
    - Conn USB lib
    - Conn USB 3D
    - Silkscreen
    - Dimensions
    [BatteryAdaptator-2024.kicad_pcb, BatteryAdaptator-2024.kicad_sch, BatteryAdaptator-2024.step, USB_A_3_Vertical-USB A 3.0 Vertical.step, USB_A_3_Vertical.FCStd]
2023-10-08 Added USB PCB connector
    [pami_2024.FCStd]
2023-10-21 Add insert and screw for PCB
2023-10-21 add TMC2208 reorgnise components
    [MainBoard-PAMI-2024.kicad_pcb, MainBoard-PAMI-2024.kicad_sch, TMC2208_SILENTSTEPSTICK.step]
2023-10-22 add capacitor for ESP32
    [MainBoard-PAMI-2024.kicad_sch]
2023-10-30 Create Dissipator for TMC
    [Dissipateur-DissipateurTMC2208.step, Dissipateur.FCStd, PinSocket_1x08_P2.54mm_Vertical.step]
2023-10-30 New version
    - Wire pins
    - Add PCB way
    - Change Cutout
    - Update 3D
    [MainBoard-PAMI-2024.kicad_pcb, MainBoard-PAMI-2024.kicad_sch]
2023-10-30 create 3D PCB and components
2023-10-30 Change Cutout
    [MainBoard-PAMI-2024.kicad_pcb]
2023-10-30 Add new PCB
    [pami_2024.FCStd]
2023-11-01 First routing
    [MainBoard-PAMI-2024.kicad_pcb, MainBoard-PAMI-2024.kicad_sch]
2023-11-01 New PCB (Routing)
    [pami_2024.FCStd]
2023-11-01 Fix XT60 (Histo t'as vu)
    [MainBoard-PAMI-2024.kicad_pcb, MainBoard-PAMI-2024.kicad_sch]
2023-11-01 New PCB version
    [pami_2024.FCStd]
2023-11-02 fix cutout
    [MainBoard-PAMI-2024.kicad_pcb]
2023-11-27 Fix top robot and add pad
    [pami_2024.FCStd]
2023-12-13 Create DummyPAMI.FCStd
    Create pami for homologation.
    [DummyPAMI.FCStd]
2023-12-13 update PAMI - Sensor orientation
    - Add diffuse acrylic for RGB led
    - Change switch length
    - Change sensor orientation (main modification)
    [pami_2024.FCStd]
2023-12-13 First upload - All tests OK
    - Testing firmware
    - Simple functions
    - Arduino IDE file -> should be move to PIO soon
    - All the main function of the robot works correctly
2023-12-16 Update wings and rapid screw position
    [pami_2024.FCStd]
2023-12-16 clean arborescence
    [pami_2024.FCStd]
2023-12-17 AccelStepper -> TeensyStep (fork ESP32Step)
2023-12-17 Antenna test (WIP)
2023-12-17 add oled on wing
    [pami_2024.FCStd]
2023-12-18 fix slow oled
    delete delay(1000) -> test forget
    [ihm.cpp]
2023-12-19 reverse - Go for AccelStepper 😥
    [ihm.cpp, main.cpp, motion.cpp, motion.h]
2023-12-20 Implement task to update motors
2024-02-02 add info on cap boot
    [MainBoard-PAMI-2024.kicad_sch]
2024-02-02 minor fix and horn
    [pami_2024.FCStd, servo-horn.FCStd]
2024-02-03 try to fix the non-reseting issue with PAMI 2 and 3
    [main.cpp]
2024-02-03 update Antennas - Remove Task
2024-02-04 minor view fix
    [pami_2024.FCStd]
2024-02-27 upstream change before switch to new repository
2024-02-27 New tool for datum
    [CaleBordure.FCStd, pami_2024.FCStd, tirette-pami.FCStd]
2024-03-27 minor fix
    [pami_2024.FCStd]
2024-04-07 Add sensors and match time - READY FOR BELGIUM !!!!
2024-04-07 V2 - PETG
    [CaleBordure.FCStd]
2024-05-01 new tirette
    [tirette-pami-magnet.FCStd]
2025-05-25 WIP Drawing PAMI
    [pami_2024.FCStd, servo-horn.FCStd]
