LesKaribous/Karibous-2024-PAMI/(notices)

Notices in the files:
ECAD/Librairies/PinSocket_1x08_P2.54mm_Vertical.step:
Copyright (C) 2017, Terje Io
This work is licensed under the Creative Commons CC-BY-SA 4.0 License with the following exception:
To the extent that the creation of electronic designs that use 'Licensed Material'
https://creativecommons.org/licenses/by-sa/4.0/legalcode
